Rumengruhuanruhe/HackMan3D-Orbit-Controller-For-Robot/README.md

# HackMan3D Orbit Controller










Views (https://github.com/HackMan3D/HackMan3D-Orbit-Controller)

<p align="center">
  HackMan3D Orbit Controller
</p>

An open-source, fully 3D-printable 6-DOF navigation controller built around an Arduino Pro Micro and four Hall-effect joysticks. Orbit provides native 3D-controller input for CAD applications and an optional mouse-emulation mode for slicers.

The Robot_Joystick version added bluetooth module and battery module. The joystick is provided AS IS, for development and educational use only. No warranty, express or implied, is given for safety, stability or reliability.
The operator shall be solely responsible for risk assessment, emergency-stop setup, safety guarding, and all operations of the robotic arm.
The author/supplier shall not be liable for any personal injury, property damage or consequential loss arising from improper operation, communication delay, signal dropout, firmware bug, modification, or misuse of this controller.
By using this joystick, you agree to accept all risks.
<p align="center">
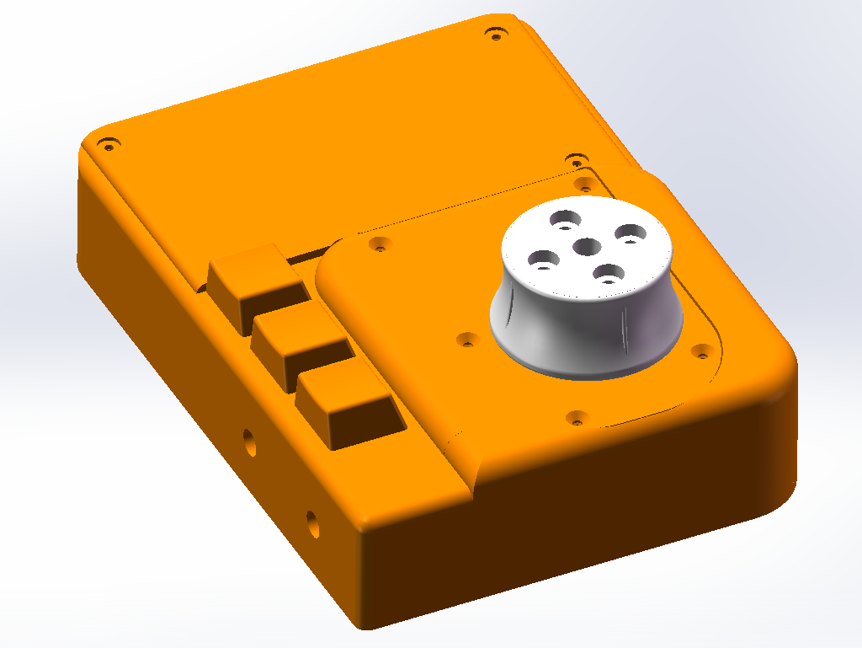
[picture p1: images/robot_joystick.png]
  
</p>

## Start here

1. Download the ready-to-use package from the [latest release](https://github.com/HackMan3D/HackMan3D-Orbit-Controller/releases/latest).
2. Print the parts from [Creality Cloud](https://www.crealitycloud.com/model-detail/hackman3d-orbit-controller) or [MakerWorld](https://makerworld.com/en/models/3009119).
3. Order the components listed in the [Bill of Materials](Documentation/HackMan3D_Orbit_Controller_BOM.pdf), or use the [complete Orbit component kit](https://s.click.aliexpress.com/e/_c3OkgxjX).
4. Follow the [Assembly Guide](Documentation/HackMan3D_Orbit_Controller_Assembly_Guide.pdf) and [wiring diagram](Wiring/Orbit_Controller_Wiring_Diagram.png).
5. Install the [NavCore 3D Controller board package](https://github.com/NavCoree/3D-controller-Board-package) in Arduino IDE.
6. Open `Firmware/Hackman3D_Orbit_Controller/Hackman3D_Orbit_Controller.ino`, select the Arduino Pro Micro target, and upload it.
7. Keep the controller untouched for one second after connecting it while the joysticks calibrate.

The complete assembly video is available on [YouTube](https://www.youtube.com/watch?v=l8wjwXb5LGA).

The Robot_Joystick video is  available on  [Bilibili](https://www.bilibili.com/video/BV17Y436eEkv/?vd_source=822b8642c92347bbf5249149e72d8a58).

## Features

- Six degrees of freedom: translation and rotation on three axes
- Four Hall-effect joysticks for contactless position sensing
- Three adjustable speed profiles
- Configurable dead zones, gain, smoothing, response curves, and axis inversion
- Multi-axis input with optional dominant-axis filtering
- Three configurable shortcut buttons
- Optional slicer mouse-emulation mode
- Native USB HID operation; no Orbit application is required
- Windows, macOS, and Linux support

## Compatibility

Orbit works with applications that support 3Dconnexion-style HID controllers, including:

| Category | Tested or commonly supported applications |
|---|---|
| CAD and 3D | Fusion 360, Blender, SolidWorks, FreeCAD, Onshape, Autodesk Inventor, Rhino |
| Slicers | Bambu Studio, Cura, PrusaSlicer |
| Operating systems | Windows, macOS, Linux |

Application support can vary by version and operating system. Slicers without native 3D-mouse support can use Orbit's optional mouse-emulation mode.

## Hardware

- 1× Arduino Pro Micro, ATmega32U4, 5 V / 16 MHz, USB-C
- 4× JH16 Hall-effect joystick modules
- 3× optional mechanical keyboard switches
- Female-to-female Dupont wires, approximately 15 cm
- USB-C data cable
- 3D-printed parts
- Fasteners:
  - 4× M2×10 countersunk
  - 6× M2×6 countersunk
  - 4× M3×6 socket head
  - 2× M3×8 socket head
  - 4× M3×10 socket head
  - 1× M3×12 socket head

Check the [Bill of Materials](Documentation/HackMan3D_Orbit_Controller_BOM.pdf) before ordering.

> **Quick purchase link:** [Complete Orbit component kit on AliExpress](https://s.click.aliexpress.com/e/_c3OkgxjX) — an economical option that can cost less than buying the components individually. Compare the current total including promotions and shipping, and check the seller's included-parts list before ordering.

> **Affiliate links:** The kit link above and the purchase links in the BOM are affiliate links. Using them supports future open-source projects at no additional cost to you.

### Amazon US component links

**Affiliate disclosure:** As an Amazon Associate I earn from qualifying purchases.
The links below lead to Amazon.com (US). Check the selected variant and pack
contents before ordering. These listings were compared with the documented
requirements; the exact seller products have not been physically validated.

| Component | Quantity needed | Amazon US listing / notes |
|---|---|---|
| Pro Micro, ATmega32U4, 5 V / 16 MHz | 1 | [DORHEA USB-C, 1 board](https://www.amazon.com/dp/B0GSZ4QDZW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) — Check board dimensions and pinout against the assembly guide. |
| Mechanical switches (optional) | 3 | [BlingKingdom, pack of 10](https://link.amazon/B02E2ec8C) — MX-style blue clicky, 3-pin; check fit in the printed switch support. |
| Female-to-female Dupont wires | As required | [EDGELEC, 120 wires, 15 cm](https://link.amazon/B0iePtvr1) — 2.54 mm connectors. |
| USB-C data cable | 1 | [ZeroneTeck USB-C to USB-C, 3 ft](https://link.amazon/B075uRWBR) — For a USB-C host; confirm USB-C-to-C operation with your board. A basic USB data cable is sufficient; 20 Gbps / 100 W is not required. |
| M2 countersunk screws | 6 × M2×6; 4 × M2×10 | [WZHUIDA M2, 660-piece assortment](https://link.amazon/B04AuJdUT) — Includes nuts and washers; both required screw lengths are listed. |
| M3 socket-head screws | 4 × M3×6; 2 × M3×8; 4 × M3×10; 1 × M3×12 | [Fgruh M3, 1,120-piece assortment](https://link.amazon/B07yC1JMR) — Includes nuts and washers; all four required lengths are listed. |

The four **JH16 Hall-effect joysticks** are still required. Use the existing
Bill of Materials or complete-kit link for these; no Amazon replacement has
been validated. Printed parts are obtained from the model links above.

## Controls

### CAD mode

- Move and twist the knob for translation and rotation.
- Press all three buttons together to cycle through the speed profiles.

### Slicer mouse mode

Hold buttons 2 and 3 together to switch between CAD mode and slicer mouse mode.

| Button | Short press | Long press |
|---|---|---|
| 1 | Tab | Command + Shift + G |
| 2 | N | L |
| 3 | Command + 0 | A |

The default shortcuts target macOS workflows and can be changed in the firmware. Pressing all three buttons still changes the speed profile.

## Tuning and troubleshooting

The controller calibrates itself every time it starts. Place it on a stable surface, do not touch the knob, and wait about one second after connecting it.

If an axis drifts, feels too sensitive, moves in the wrong direction, or needs a different response curve, use the [Tuning Guide](TUNING_GUIDE.md). All user-adjustable values are grouped near the top of the firmware.

For problems:

1. Review the [open issues](https://github.com/HackMan3D/HackMan3D-Orbit-Controller/issues).
2. Confirm that the USB cable supports data.
3. Confirm the selected Arduino board and port.
4. Open a [bug report](https://github.com/HackMan3D/HackMan3D-Orbit-Controller/issues/new?template=bug_report.yml) with the requested diagnostic information.

## Repository contents

| Path | Contents |
|---|---|
| `Firmware/` | Arduino source code |
| `Documentation/` | Assembly guide and Bill of Materials |
| `Wiring/` | Pinout and wiring diagrams |
| `images/` | Project media |
| `TUNING_GUIDE.md` | Calibration and response settings |
| `CHANGELOG.md` | Published version history |

## Contributing

Bug fixes, documentation improvements, hardware feedback, and tested enhancements are welcome. Read [CONTRIBUTING.md](CONTRIBUTING.md) before opening a pull request.

Please report security-sensitive problems according to [SECURITY.md](SECURITY.md), rather than in a public issue.

## License

The repository is licensed under the [GNU Affero General Public License v3.0](LICENSE). Printable model platforms may provide their files under separate terms; check the license shown on the relevant model page before redistributing them.

Orbit is an independent community project and is not affiliated with or endorsed by 3Dconnexion.

## Credits and support

Designed and maintained by **HackMan3D**.

Additional features, testing, and feedback by [Kitek](https://www.crealitycloud.com/user/7734397320).

Special thanks to [NavCore](https://github.com/NavCoree/3D-controller-Board-package) for the Arduino board package that enables native 3D-controller compatibility on the Pro Micro.

If Orbit is useful to you, star the repository, share your build, and help other makers by reporting your tested hardware and software combinations.
