Rumengruhuanruhe/HackMan3D-Orbit-Controller-For-Robot/Documentation/BOM_robot_joystick.xlsx

NO | Parts | Qty | SPE(searching from Taobao，自行淘宝购买）
1 | Hall Sensor霍尔摇杆 | 4 | 控银JS16ProTMR青鸾摇杆替换国产手柄不漂移高精度
2 | Ardunio Pro Micro | 1 | Pro Micro开发板 ATMega32U4 5V/16M 支持Arduino IDE
3 | Bluetooth HC-05蓝牙模块 | 1 | HC-05-06-08-02主从机一体蓝牙模块板DIY无线串口透传电子模块
4 | Switch | 3 | MX键盘按钮 黑轴红轴青轴樱桃轴体正品机械开关 电脑键盘按键开关
5 | Resistor电阻 | 2 | 1KΩ&2.2KΩ
6 | Dupon Cables杜邦线 | 1 | 杜邦线 母对母15CM,
7 | Battery Box电源盒 | 1 | 干电池手机应急充电器手机五号电池充电宝5号电池移动电源电源盒
8 | PCB洞洞板2cm*2cm | 1
9 | Pins端子 | 4
10 | Spring_double_stick_10mm 双面弹簧 | 4
11 | Spring小弹簧0.4*5*5 | 1
13 | Screw M3*6螺丝 | 4
14 | Screw M3*10螺丝 | 3
15 | Screw M2*6螺丝 | 12
16 | Screw M2*10螺丝 | 4
17 | USB-TypeC cble_10cm | 1
