Rumengruhuanruhe/HackMan3D-Orbit-Controller-For-Robot/Wiring/wiring_robot_joystick.xlsx

Pro Micro | Hall Joystick | Switch | HC-05 | PCB-20*20
TXO |  |  |  | P1
RXI |  |  | RXD | P2
GND |  | COM 公共端 | GND | P4
GND |  |  |  | P3
2 |  | Key1
3 |  | Key2
4 | Front-P3
5
6 | Front-P2
7 |  | Key3
8 | Right-P3
9 | Right-P2
RAW
GND | 上P5,下P5,左P5,右P5,
RST
VCC | FrontP1,RearP1,LeftP1,RightP1, |  | VCC
A3 | Left-P2
A2 | Left-P3
A1 | Rear-P2
A0 | Rear-P3
15
14
16
10
