Rumengruhuanruhe/HackMan3D-Orbit-Controller-For-Robot/(commit log)

2026-11-03 ADD bluetooth module and batterry module
    the new Joystick can teaching robot wia bluetooth.
    [接线图.xlsx]
2026-11-03 Add bluetooth module and battery module
    [wiring_vrobot.xlsx]
2026-11-03 add bluetooth module and battery
    for robot joystick
    [wiring_robot_joystick.xlsx]
