Rumengruhuanruhe/HackMan3D-Orbit-Controller-For-Robot/(notices)

Notices in the files:
README.md:
License: AGPL-3.0
